its-Hashim/Akvo-Development/Block Diagram of 36K.JPG

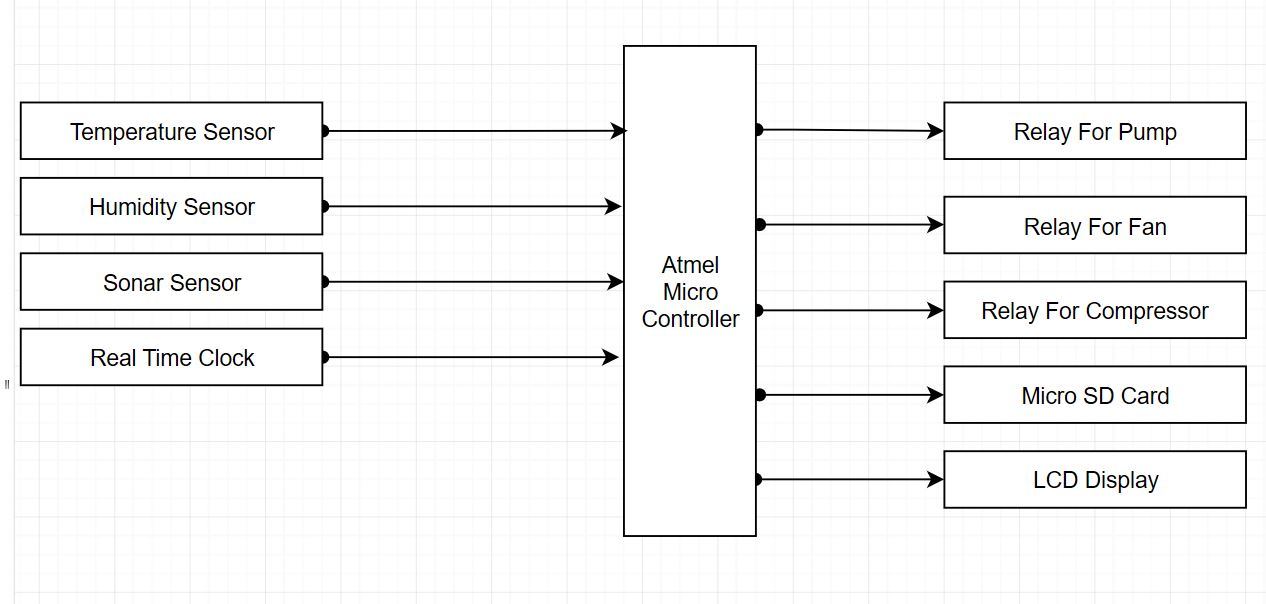
Block Diagram of 36K.JPG
