its-Hashim/Akvo-Development/saboot.JPG

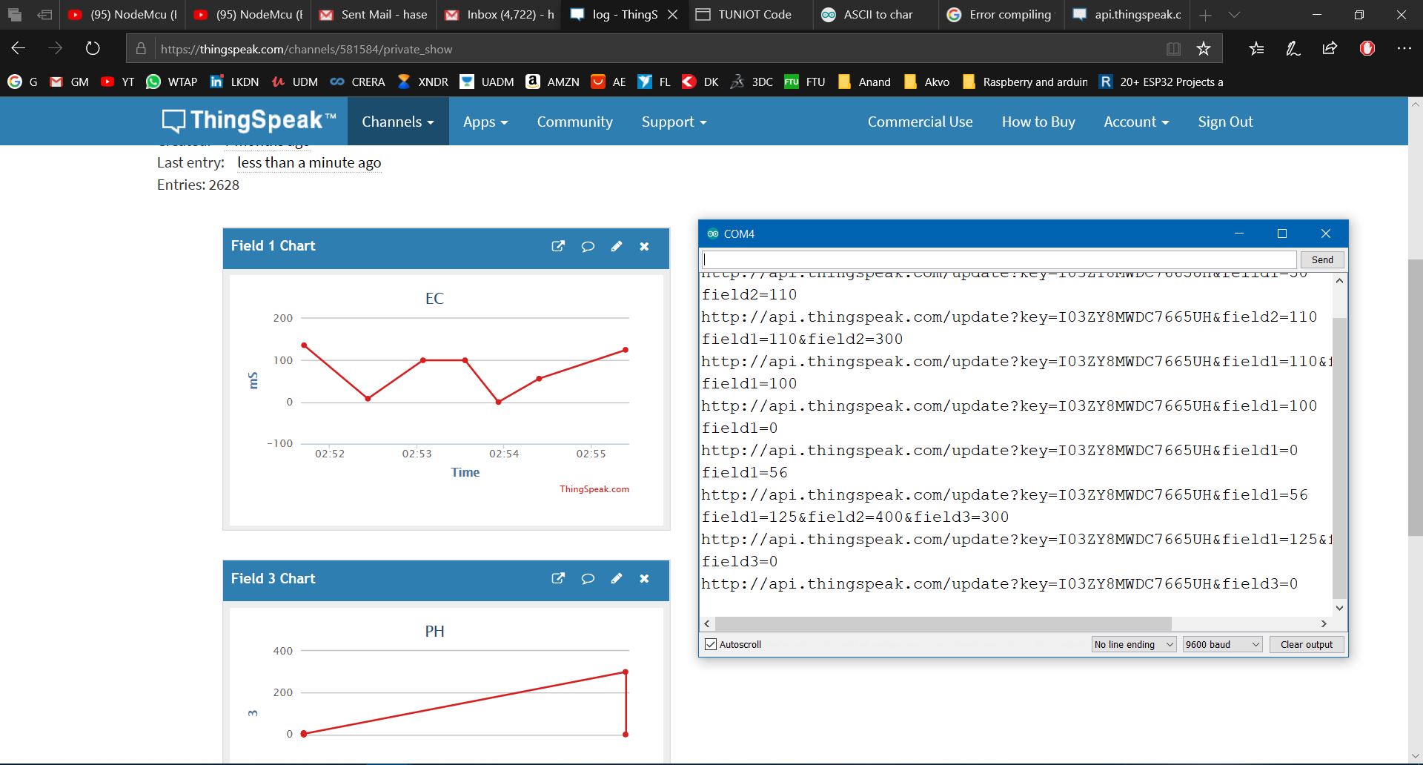
saboot.JPG
