its-Hashim/Akvo-Development/save.JPG

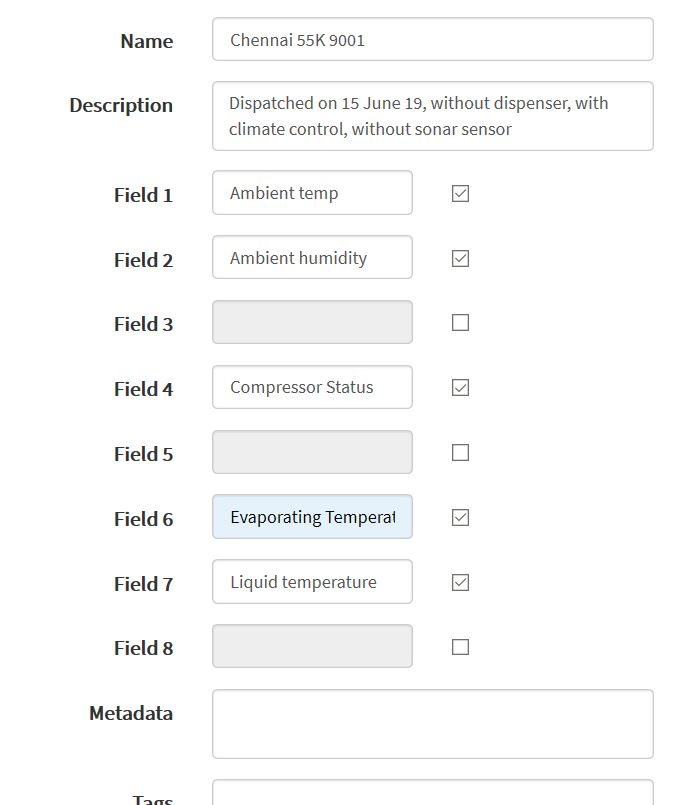
save.JPG
