its-Hashim/Akvo-Development/System Block Diagram.PNG

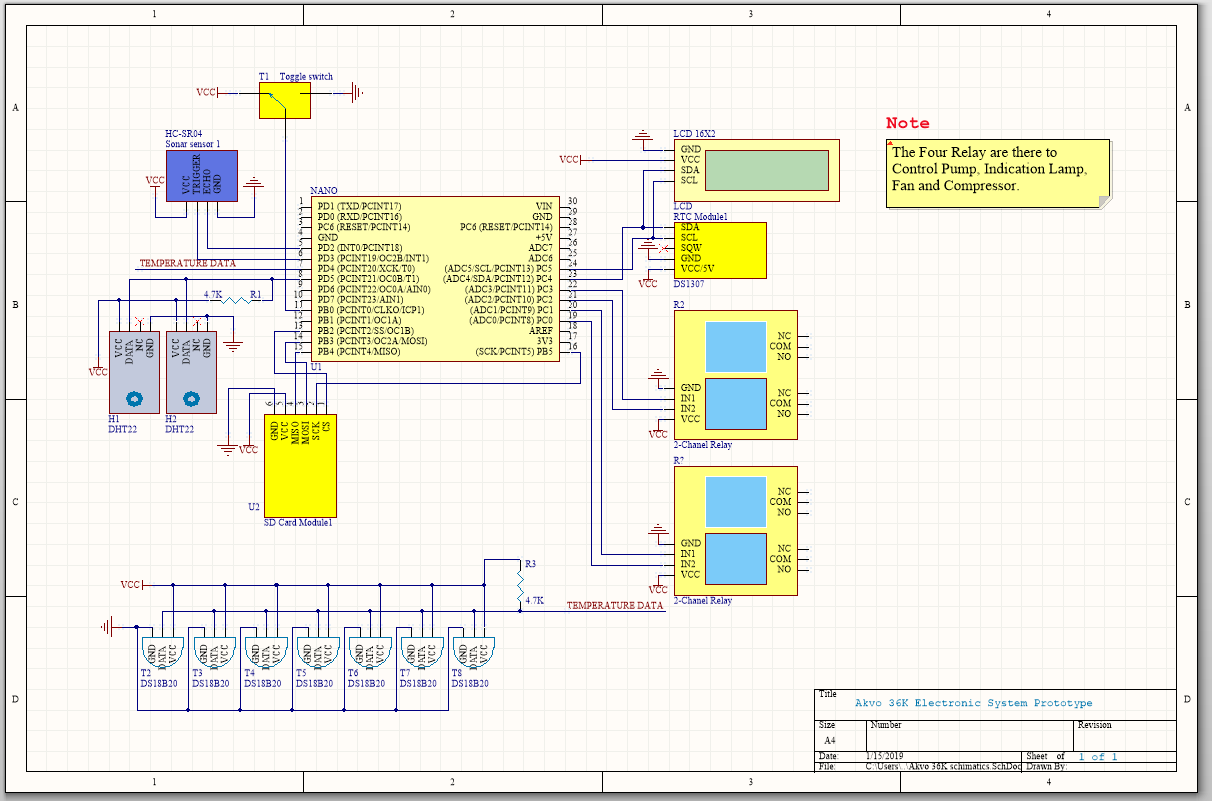
System Block Diagram.PNG
