its-Hashim/Akvo-Development/BOM 36K 10Pc Order.pdf

Name | Part No. | Price Per Unit | Quantity | Unit | Price2
Capacitor for decoupling 0.1uF | 2 | 20 Nos | 40
2 Pin Connector | 7 | 80 Nos | 560
3 Pin Connector | 10 | 120 Nos | 1200
Header Male | 10 | 10 Nos | 100
Header Female | 10 | 20 Nos | 200
5V adaptor | 300 | 12 Nos | 3600
toggle switch spst Blue or black | 20 | 15 Nos | 300
5V 10A Relay | 50 | 30 Nos | 1500
1K Resistor | 2 | 30 | 60
4.7K ohn resistor | 2 | 100 Nos | 200
Diode (1N4007) | 2 | 10 Nos | 20
2N2222 Transistor | 30 | 0
Total | 477 | 7780
