its-Hashim/Akvo-Development/BOM 36K 10Pc Order.xlsx

Sheet: AIS
Name | Part No. | Price Per Unit | Quantity | Unit | Price2
Capacitor for decoupling 0.1uF |  | 2 | 20 | Nos | 40
2 Pin Connector |  | 7 | 80 | Nos | 560
3 Pin Connector |  | 10 | 120 | Nos | 1200
Header Male |  | 10 | 10 | Nos | 100
Header Female |  | 10 | 20 | Nos | 200
5V adaptor |  | 300 | 12 | Nos | 3600
toggle switch spst Blue or black |  | 20 | 15 | Nos | 300
5V 10A Relay |  | 50 | 30 | Nos | 1500
1K Resistor |  | 2 | 30 |  | 60
4.7K ohn resistor |  | 2 | 100 | Nos | 200
Diode (1N4007) |  | 2 | 10 | Nos | 20
2N2222 Transistor |  |  | 30 |  | 0
Total |  |  | 477 |  | 7780

Sheet: AIS (2)
Name | Part No. | Price | Quantity | Unit | Avaibility | Price2
Sonar sensor | HC-SR04 | 120 | 1 | Nos | Chandni | 120
Dispensing Button |  | 100 | 1 | Nos | Chandni | 100
Humidity Sensor | DHT-22 | 300 | 0 | Nos | Chandni | 0
4.7k | 1-watt | 2 | 2 | Nos | Chandni | 4
Real Time Clock Module with battery |  | 90 | 1 | Nos | Chandni | 90
Temperature Sensor Waterproof probe | DS18B20 | 140 | 0 | Nos | Chandni | 0
Temperature Sensor | DS18B20 | 140 | 2 | Nos | Chandni | 280
5V 10A Relay |  | 85 | 2 | Nos | Chandni | 170
Micro SD Card Module |  | 80 | 0 | Nos | Chandni | 0
16X2 LCD Disply with I2C backpack |  | 300 | 0 | Nos | Chandni | 0
Arduino Nano |  | 230 | 1 | Nos | Chandni | 230
5V Adaptor |  | 250 | 1 | Nos | Chandni | 250
Diode |  | 15 | 2 | Nos | Chandni | 30
2GB Micro SD Card |  | 150 | 0 | Nos | Chandni | 0
Capacitor for decoupling |  | 20 | 2 | Nos | Chandni | 40
2 Pin Connector |  | 10 | 1 | Nos | Chandni | 10
3 Pin Connector |  | 15 | 2 | Nos | Chandni | 30
4 Pin Connector |  | 20 | 1 | Nos | Chandni | 20
Mounting Nut and Screw 4mm |  | 3 | 4 | Nos | Chandni | 12
PCB |  | 150 | 1 | Nos | jlcpcb.com | 150
0.5sq mm 4 core, Ultrasonic sensor |  |  | 2.5 | Meter |  | 0
0.5 sq mm 2 core, Temperature sensor |  |  | 1 | Meter |  | 0
2.5 sq mm 3 core, Supply power |  |  | 3.5 | Meter |  | 0
1 sq mm 3 core, Fan supply |  |  | 0.5 | Meter |  | 0
2.5 sq mm 3 core, compressor |  |  | 0.5 | Meter |  | 0
 |  |  |  |  |  | 0
 |  |  |  |  |  | 0
Total |  |  | 32 |  |  | 1536
