its-Hashim/Akvo-Development/BOM AIS and existing testing.xlsx

Name | Part No. | Price | Quantity | Avaibility | Extra piece | Total Quantity | Price | Price including extra
Sonar sensor | HC-SR04 | 70 | 1 | Chandni | 1 | 2 | 70 | 70
Toggle switch |  | 5 | 1 | Chandni | 0 | 1 | 5 | 0
Humidity Sensor | DHT-22 | 300 | 2 | Chandni | 1 | 3 | 600 | 300
Resistor Box |  | 25 | 1 | Chandni | 0 | 1 | 25 | 0
10K, 4.7k, 1k, 330,100 | 1-watt | 5 | 10 | Chandni | 0 | 10 | 50 | 0
Real Time Clock Module with battery |  | 90 | 1 | Chandni | 0 | 1 | 90 | 0
Temperature Sensor Waterproof probe | DS18B20 | 140 | 2 | Chandni | 0 | 2 | 280 | 0
Temperature Sensor | DS18B20 | 140 | 4 | Chandni | 1 | 5 | 560 | 140
Relay 2-Chanel Module 5V |  | 90 | 1 | Chandni | 1 | 2 | 90 | 90
Micro SD Card Module |  | 70 | 1 | Chandni | 0 | 1 | 70 | 0
16X2 LCD Disply with I2C backpack |  | 240 | 1 | Chandni | 0 | 1 | 240 | 0
Arduino Nano |  | 230 | 1 | Chandni | 1 | 2 | 230 | 230
Vero Board (Big Size) |  | 35 | 2 | Chandni | 2 | 4 | 70 | 70
5V 3A SMPS or adaptor |  | 300 | 1 | Chandni | 0 | 1 | 300 | 0
Jumper (M-M, M-F,F-F) |  | 144 | 1 | Chandni | 0 | 1 | 144 | 0
Heat shrink 2mm,3mm and 4mm |  | 30 | 1 | Chandni | 0 | 1 | 30 | 0
1k and 10K Pot (10 thread) |  | 20 | 0 | Chandni | 1 | 1 | 0 | 20
Indication Lamp |  | 80 | 1 | Chandni | 0 | 1 | 80 | 0
Total |  |  |  |  | 8 | 40 | 2934 | 920
