its-Hashim/Akvo-Development/BOM prototype.xlsx

Name | Part No. | Price | Quantity Required | Avaibility | Extra piece | Total Quantity | Price | Additional cost
Sonar sensor | HC-SR04 | 90 | 3 | Chandni | 2 | 5 | 270 | 180
Toggle switch |  | 5 | 1 | Chandni | 0 | 1 | 5 | 0
Humidity Sensor | DHT-22 | 360 | 2 |  | 2 | 4 | 720 | 720
Resistor Box |  | 25 | 1 | Chandni | 0 | 1 | 25 | 0
10K, 4.7k, 1k, 330,100 | 1-watt | 5 | 10 | Chandni | 0 | 10 | 50 | 0
Real Time Clock Module with battery |  | 220 | 1 | Chandni | 0 | 1 | 220 | 0
Temperature Sensor Waterproof probe | DS18B20 | 199 | 2 |  | 1 | 3 | 398 | 199
Temperature Sensor | DS18B20 | 200 | 4 | Chandni | 2 | 6 | 800 | 400
Relay 2-Chanel Module 5V |  | 255 | 1 | Chandni | 1 | 2 | 255 | 255
Micro SD Card Module |  | 152 | 1 |  | 0 | 1 | 152 | 0
16X2 LCD Disply with I2C backpack |  | 330 | 1 | Chandni | 0 | 1 | 330 | 0
Arduino Nano |  | 279 | 1 | Chandni | 1 | 2 | 279 | 279
Vero Board (Big Size) |  | 40 | 2 | Chandni | 2 | 4 | 80 | 80
5V 3A SMPS or adaptor |  | 364 | 1 | Chandni | 0 | 1 | 364 | 0
Jumper (M-M, M-F,F-F) |  | 190 | 1 | Chandni | 0 | 1 | 190 | 0
Heat shrink 2mm,3mm and 4mm |  | 60 | 1 | Chandni | 0 | 1 | 60 | 0
1k and 10K Pot (10 thread) |  | 20 | 0 | Chandni | 1 | 1 | 0 | 20
Indication Lamp |  | 83 | 1 | Chandni | 0 | 1 | 83 | 0
Total |  |  |  |  |  | 46 | 4281 | 2133
