its-Hashim/Akvo-Development/BOM.xlsx

Name | Part No. | Unit cost | Quantity | Avaibility | Extra piece | Total Quantity | Price | Price including extra
Sonar sensor | HC-SR04 | 70 | 1 | Chandni | 1 | 2 | 70 | 70
Humidity Sensor | DHT-22 | 300 | 2 | Chandni | 1 | 3 | 600 | 300
Real Time Clock Module and battery | DS3231 | 90 | 1 | Chandni | 0 | 1 | 90 | 0
Temperature Sensor Waterproof probe | DS18B20 | 140 | 2 | Chandni | 0 | 2 | 280 | 0
Temperature Sensor | DS18B20 | 140 | 4 | Chandni | 1 | 5 | 560 | 140
16X2 LCD Disply with I2C backpack | HD44780 | 240 | 1 | Chandni | 0 | 1 | 240 | 0
Micro SD Card Module for arduino |  | 70 | 1 | Chandni | 0 | 1 | 70 | 0
Arduino Nano |  | 230 | 1 | Chandni | 1 | 2 | 230 | 230
10K, 4.7k, 1k, 330,100 |  | 5 | 10 | Chandni | 0 | 10 | 50 | 0
Toggle switch medium size |  | 5 | 1 | Chandni | 0 | 1 | 5 | 0
Resistor Box |  | 25 | 1 | Chandni | 0 | 1 | 25 | 0
2-Chanel 5V Relay |  | 90 | 1 | Chandni | 1 | 2 | 90 | 90
Vero Board (Big Size) |  | 35 | 2 | Chandni | 2 | 4 | 70 | 70
5V 3A SMPS or adaptor |  | 300 | 1 | Chandni | 0 | 1 | 300 | 0
Jumper (M-M, M-F,F-F) |  | 144 | 1 | Chandni | 0 | 1 | 144 | 0
Heat shrink 2mm,3mm and 4mm |  | 30 | 1 | Chandni | 0 | 1 | 30 | 0
1k and 10K Pot (10 thread) |  | 20 | 0 | Chandni | 1 | 1 | 0 | 20
Indication Lamp |  | 80 | 1 | Chandni | 0 | 1 | 80 | 0
Header Pin Male and Female |  | 10 | 4 | Chandni | 4 | 8 | 40 | 40
Total |  |  |  |  | 12 | 48 | 2974 | 960
Micro SD Card Module for arduino
The module (microsd card adapter) is a micro sd card reader module, and the spi interface via the file system driver, micro controller system to complete the micro sd card
3.3v regulator circuit: Ldo regulator output 3.3v as level converter chip, micro sd card supply level conversion circuit:
Micro sd card into the direction of signals into 3.3v, microsd card toward the direction of the control interface miso signal is also converted to 3.3v, general avr microcontroller system can read the signal micro sd card connector: Yes since the bomb deck for easy card insertion and removal positioning holes: 4 m2 screws positioning hole diameter of 22mm, the module is easy to install positioning, to achieve inter-module combination
Arduino Nano
Microcontroller Atmel ATmega328 Operating Voltage (logic level): 5V Input Voltage (recommended): 7V ~ 12V Input Voltage (limits): 6V ~ 20 V
Digital I/O Pins: 14 (of which 6 provide PWM output) Analog Input Pins: 8 DC Current per I/O Pin: 40mA
Flash Memory: 32KB (ATmega328) (of which 2 KB used by bootloader) SRAM: 2KB (ATmega328) EEPROM: 1KB (ATmega328) Clock Speed: 16MHz
10K, 4.7k, 1k, 330,100
Resistor
Resistor Box
This is a box of resistor containing resister of all possible values and there are 5 resistor of each value
2-Chanel 5V Relay
Power relay
Low suction, high level release
Timely status light is on, release the status light is off
The default 5V relays, plug in the jumper caps
Relay Output: DC 30V/10A exchange 250V/10A
Vero Board (Big Size)
Easy to implement circuits from breadboard
Single sided
Copper layer is laminated
Jumper (M-M, M-F,F-F)
Each cable length about 20cm or 8-inch
The male ends meant for insertion into standard 0.1 inch (2.54mm) female sockets and the female ends are meant for insertion onto standard 0.1 inch (2.54mm) male headers
Heat shrink 2mm,3mm and 4mm
Shrinkage ratio: 2:1 (will maximum shrink to 1/2 its supplied diameter)
Minimum shrinkage temperature: 84 Deg.C and more
Full shrinkage temperature: 120 Deg.C and more
Operating temperature: -55 - 125 Deg.C
1k and 10K Pot (10 thread)
Pottentiometer
Power rating – 0.5 Watt
Indication Lamp
LED Indicator Lamp
Operating Voltage : 220V AC
Operating current : 20mA
Thread DIA : 22 mm / 0.87";Size : 5 x 2.7cm/ 2" x 1.1" (LED)
Header Pin Male and Female
Pitch: 2.54mm
Number of pin is 40
