its-Hashim/Akvo-Development/Akvo 36K Prototype schematics of Intelligent control System.pdf

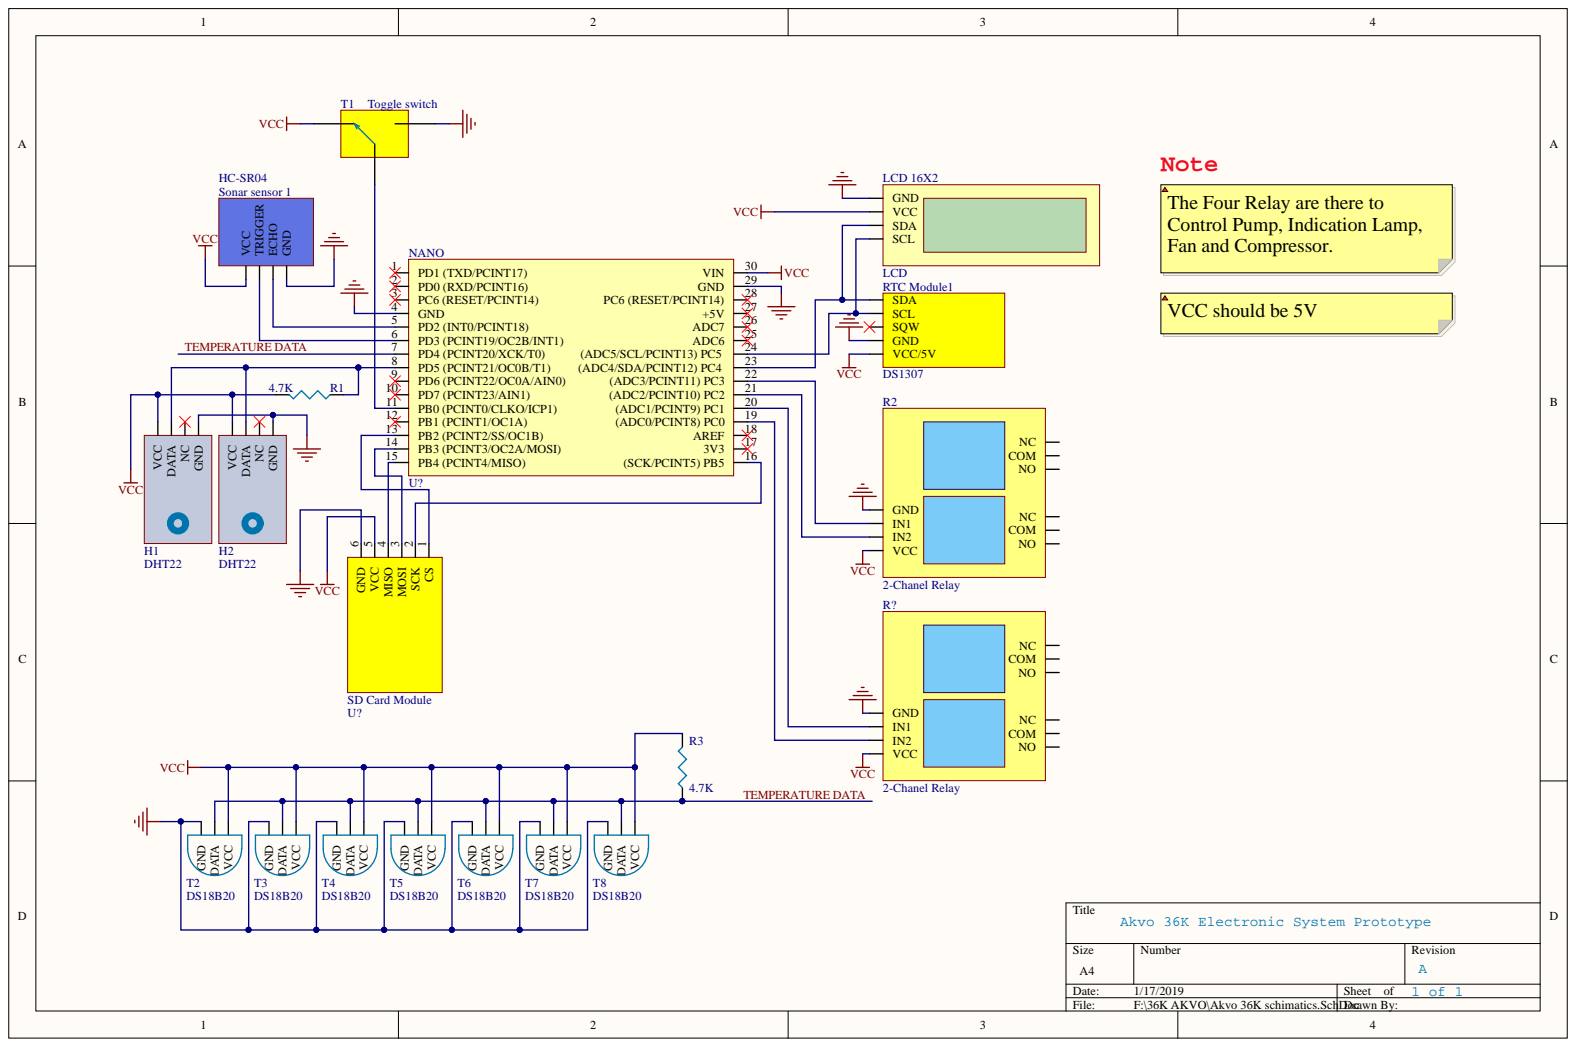
[picture p8: page 1]

The Four Relay are there to
Control Pump, Indication Lamp,
Fan and Compressor.

PD2 (INT0/PCINT18) 5
PD3 (PCINT19/OC2B/INT1) 6
PD4 (PCINT20/XCK/T0) 7
PD5 (PCINT21/OC0B/T1) 8

4.7K R1 | | PD6 (PCINT22/OC0A/AIN0) 9 | VCC DS1307

CS 1 SCK 2 MOSI 3 MISO 4 VCC 5 GND 6 SD Card Module

Akvo 36K Electronic System Prototype

Size A4 | Number | Revision A

Date: 1/17/2019 | Sheet of 1 of 1
File: F:\36K AKVO\Akvo 36K schimatics.SchDoc Drawn By:
