its-Hashim/Akvo-Development/AIS_V1.0/AIS_V1.0.ino

#include "max6675.h"
#include <Wire.h>
#include <SoftwareSerial.h>
#include <OneWire.h>
#include <DallasTemperature.h>
#include <DHT.h>
#include <DHT_U.h>
#include <DS3231.h>
DS3231  rtc(SDA, SCL);

SoftwareSerial s(12, 11);


#define trigPin 9
#define echoPin 8
#define temp3 A3
#define temp2 A2
#define DHT1PIN 7
#define DHT1TYPE DHT22
#define wifi_rst_btn 6
#define thermoDO 3
#define thermoCS 4
#define thermoCLK 5
#define comp A1
#define pump 10
#define fan A0
#define disPin 2
#define tankHeight 50

MAX6675 thermocouple(thermoCLK, thermoCS, thermoDO);

OneWire oneWire1(temp3);
DallasTemperature sensors1(&oneWire1);
OneWire oneWire2(temp2);
DallasTemperature sensors2(&oneWire2);
DHT dht1(DHT1PIN, DHT1TYPE);




long duration, distance;
unsigned long lastOffTime = 0;
unsigned long compOnTime = 0;
unsigned long lastChecked = 0;
unsigned long fanOnTime = 0;
unsigned long fanOffTime = 0;
unsigned long dispenseTime = 0;
short m = 150;
int tempC1;
int tempC2;
int temp;
int humid;

void setup() {
  rtc.begin();
  Serial.begin(9600);
  s.begin(9600);
  delay(5000);
  pinMode(wifi_rst_btn, OUTPUT);
  Serial.println("Resetting Wifi");
  digitalWrite(wifi_rst_btn, HIGH);
  delay(300);
  digitalWrite(wifi_rst_btn, LOW);
  delay(20000);
  sensors1.begin();
  sensors2.begin();
  dht1.begin();

  pinMode(trigPin, OUTPUT);
  pinMode(echoPin, INPUT);
  pinMode(comp, OUTPUT);
  pinMode(pump, OUTPUT);
  pinMode(fan, OUTPUT);
  pinMode(disPin, INPUT);
  digitalWrite(disPin, HIGH);
  delay(200);
}

void loop()
{

  sensors2.requestTemperatures();
  int tempC2 = sensors2.getTempCByIndex(0);
  if (tempC2 >= 60 && tempC2 < 100)
  {
    turnOffComp();
    turnOffComp();
    turnOffComp();
    Serial.println("The Temperature Was above 65 degree Celcius");
    delay(600000);
  }
  //    double therm = thermocouple.readCelsius();
  //    if (therm >= 60 && therm < 120)
  //    {
  //      turnOffComp();
  //      turnOffComp();
  //      turnOffComp();
  //      Serial.println("The Temperature Was above 65 degree Celcius");
  //      delay(600000);
  //    }
  //    Serial.println(therm);
  unsigned long interval = millis() - lastChecked;
  if (interval < 0)
    lastChecked = 0;
  if (interval > 3000)
  {
    Time t = rtc.getTime();
    int minute = t.min;
    int hr = t.hour;
    sensors1.requestTemperatures();
    sensors2.requestTemperatures();
    int tempC1 = sensors1.getTempCByIndex(0);
    int tempC2 = sensors2.getTempCByIndex(0);
    int temp = dht1.readTemperature();
    int humid = dht1.readHumidity() - 3;
    humid = humid * 0.94;
    distanceMeasure();
    compressor(hr, minute);
    Serial.print("The minute is ");
    Serial.println(minute);
    Serial.print("The hour is ");
    Serial.println(hr);
    if (m >= 10)
    {

      s.print("field1=" + String(temp) + "&field2=" + String(humid) + "&field3=" + String(measureHeight(distance))
              + "&field4=" + String(digitalRead(comp))   + "&field6="  + String(tempC1) + "&field7=" + String(tempC2) + "&field8=" + String(thermocouple.readCelsius()));
      Serial.println("logging data");
      Serial.println(temp);
      Serial.println(humid);
      Serial.println(tempC1);
      Serial.println(tempC2);
      Serial.println(distance);
      Serial.println(measureHeight(distance));
      m = 0;
    }
    else
    {
      m++;
    }
    lastChecked = millis();
  }
  if (digitalRead(disPin) == 0)
  {
    delay(50);
    dispenseTime = millis();
    while (digitalRead(disPin) == 0)
    {
      Serial.println(".");
      distanceMeasure();
      delay(5);
      if (distance >= 45)
        break;
      dispense();
    }
    digitalWrite(pump, LOW);
    digitalWrite(pump, LOW);
    dispenseTime = millis() - dispenseTime;
    dispenseTime = dispenseTime / 1000;
    delay(400);
    s.print("field5=" + String(dispenseTime));
    Serial.println("field5=" + String(dispenseTime));
  }
  delay(150);
  // put your main code here, to run repeatedly:

}

void compressor(int hr , int minute)
{
  Serial.println("Checking Compressor");
  unsigned long interval = millis() - lastOffTime;
  if (interval < 0)
  {
    lastOffTime = 0;
  }
  Serial.println(interval);
  if (distance > 8 && digitalRead(comp) != 1 && (hr >= 23 || hr <= 5)) // dalay to turn on the compressor is ten sec for now and will be changed after according to the condition
  {

    //Check last the compresssor
    //if the compressor was turn off for more than 3 min turn On the compressor
    Serial.println("Trying To Turn on Compressor");
    if (digitalRead(fan) != 1)
    {
      digitalWrite(fan, HIGH);
      fanOnTime = millis();
      Serial.println("Fan getting On");
    }
    else if (((millis() - fanOnTime) > 120000) && interval > 120000)
    {
      digitalWrite(comp, HIGH);
      Serial.println("Compressor getting On");
    }
  }
  else if (digitalRead(comp) != 0 && ((distance < 5 ) || (hr < 23 && hr > 5) ))
  {
    Serial.println(hr);
    Serial.println(minute);
    turnOffComp();
    compOnTime = 60000;
  }
  else if (digitalRead(fan) == 1 && digitalRead(comp) == 0 && interval > 120000 && (distance < 8 || (hr < 23 && hr > 5)))
  {
    digitalWrite(fan, LOW);
    Serial.println("Fan getting off");
  }
  else
  {
    Serial.println("not found any Condition for compresser Its state is unaltered");
  }
}

void dispense()
{
  if (distance < 45)
    digitalWrite(pump, HIGH);
  else
    digitalWrite(pump, LOW);
}

void distanceMeasure()
{
  digitalWrite(trigPin, LOW);  // Added this line
  delayMicroseconds(2); // Added this line
  digitalWrite(trigPin, HIGH);
  delayMicroseconds(10); // Added this line
  digitalWrite(trigPin, LOW);
  duration = pulseIn(echoPin, HIGH);
  distance = (duration / 2) / 29.1;
  Serial.println("The Distance is ");
  Serial.println(distance);
}
short measureHeight(int d)
{
  Serial.println("Measuring Tank level");
  Serial.println(d);
  short measure = ((d) / 50.0) * 100.00;
  if (measure > 100 || measure < 0)
    return (00);
  else
    return ((100 - measure));
}
void turnOffComp()
{
  digitalWrite(comp, LOW);
  lastOffTime = millis();
  Serial.println("Compressor getting off");

}
