its-Hashim/Akvo-Development/ESP8266_Smart_Config_test/ESP8266_Smart_Config_test.ino

#include <ESP8266WiFi.h>



void setup() {

  Serial.begin(115200);

  /* Set ESP8266 to WiFi Station mode */

  WiFi.mode(WIFI_STA);

  /* start SmartConfig */

  WiFi.beginSmartConfig();



  /* Wait for SmartConfig packet from mobile */

  Serial.println("Waiting for SmartConfig.");

  while (!WiFi.smartConfigDone()) {

    delay(500);

    Serial.print(".");

  }

  Serial.println("");

  Serial.println("SmartConfig done.");



  /* Wait for WiFi to connect to AP */

  Serial.println("Waiting for WiFi");

  while (WiFi.status() != WL_CONNECTED) {

    delay(500);

    Serial.print(".");

  }

  Serial.println("WiFi Connected.");

  Serial.print("IP Address: ");

  Serial.println(WiFi.localIP());

}

void loop() {

}
